kt140/ECE445_SeniorDesign/README.md

# ECE 445: Senior Design - Team 7

## 	Project - Optimized solar charging off grid for several output voltage potentials

This is the senior design project for Kanin Tangchartsiri (kanint2), Lukas Gollings (lwg2), and Wonjoon Lee (wonjoon2).
