kt140/ECE445_SeniorDesign/Notebooks/Kanin/BUCK_COLLAB_NOTEBOOK.jpg

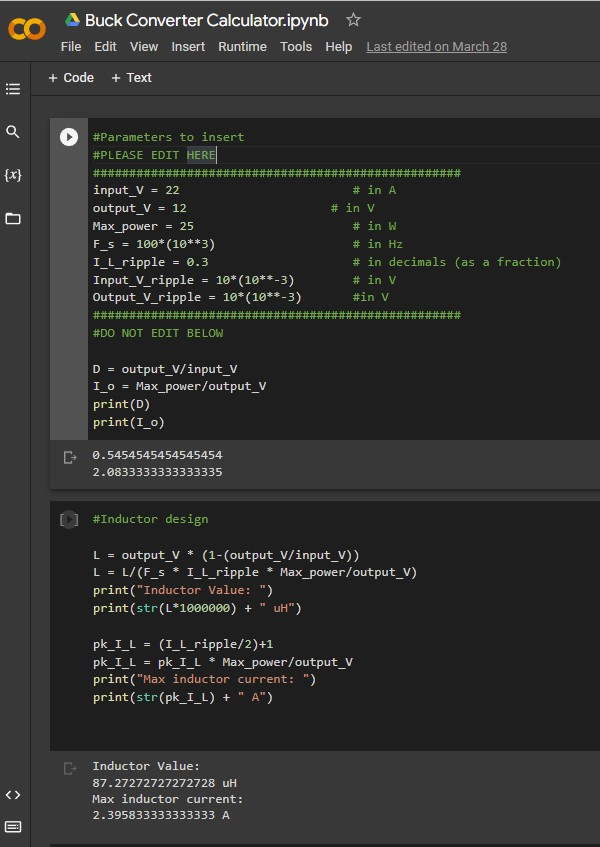
Notebooks/Kanin/BUCK_COLLAB_NOTEBOOK.jpg
