kt140/ECE445_SeniorDesign/Notebooks/Kanin/FINAL_GATE_DRIVERS.jpg

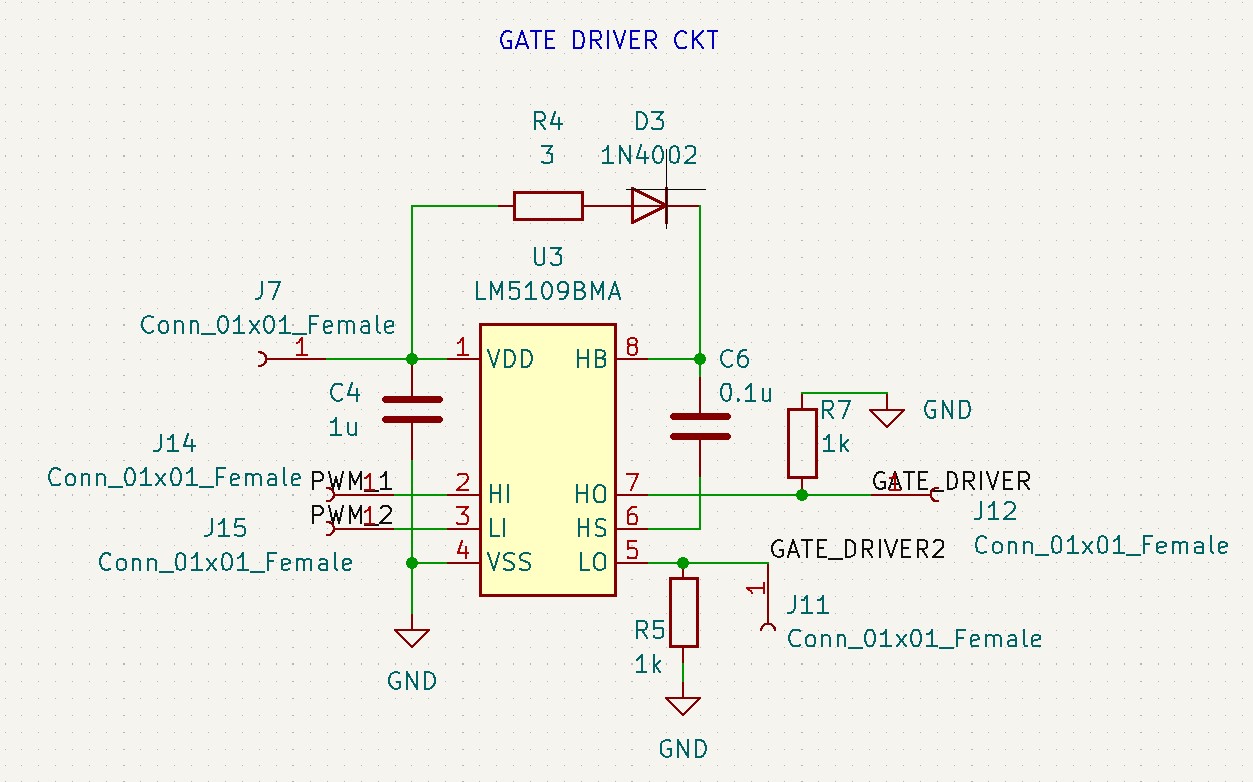
Notebooks/Kanin/FINAL_GATE_DRIVERS.jpg
