kt140/ECE445_SeniorDesign/Notebooks/Kanin/finalized_power_board_schem.jpg

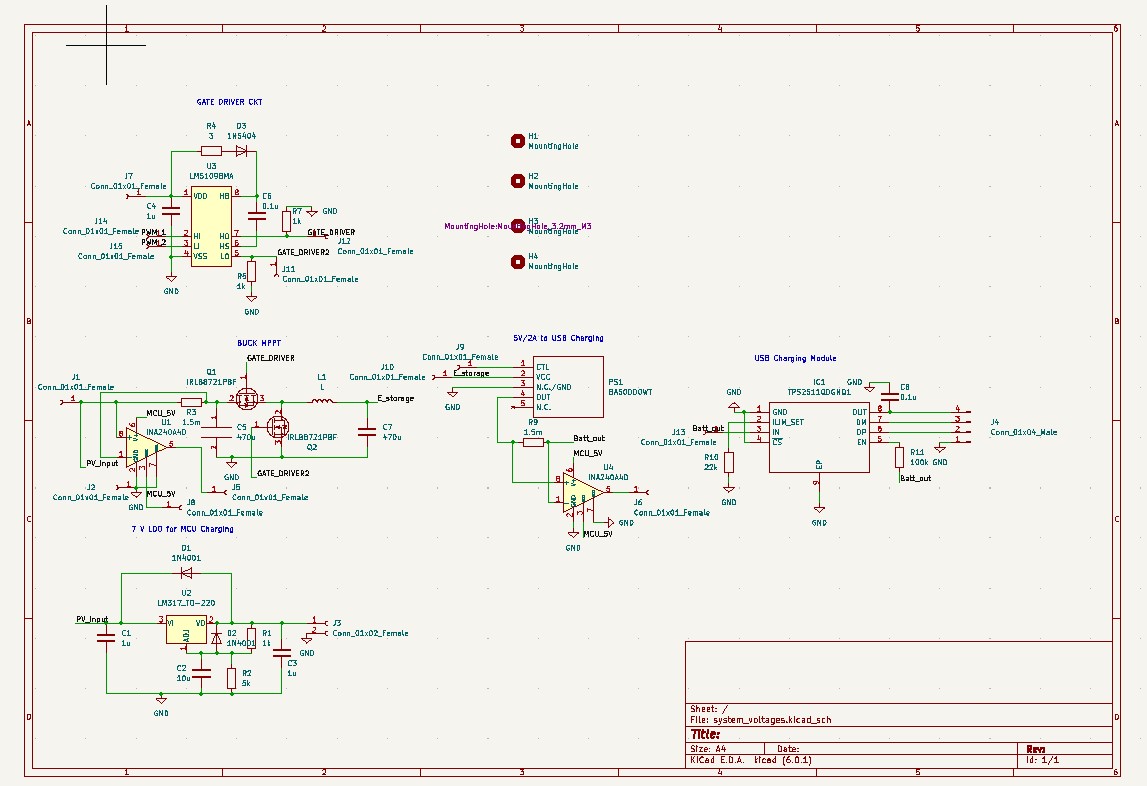
Notebooks/Kanin/finalized_power_board_schem.jpg
