kt140/ECE445_SeniorDesign/Notebooks/Kanin/incomplete_PCB.jpg

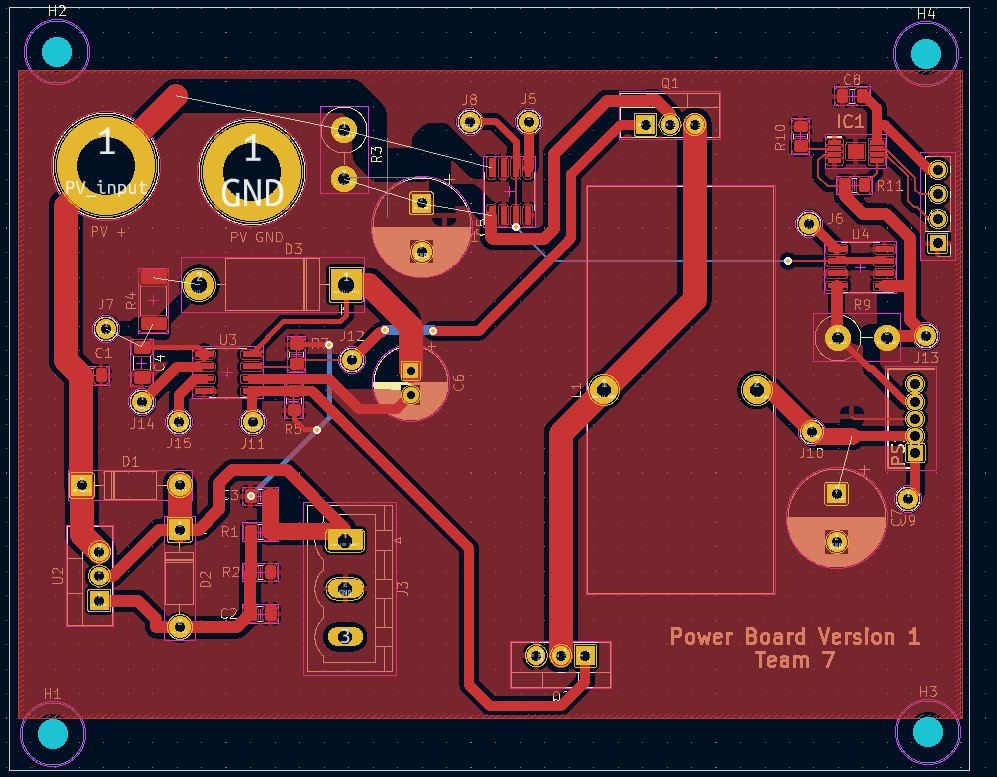
Notebooks/Kanin/incomplete_PCB.jpg
