kt140/ECE445_SeniorDesign/Notebooks/Kanin/runningsimulation4buckcorrection.jpg

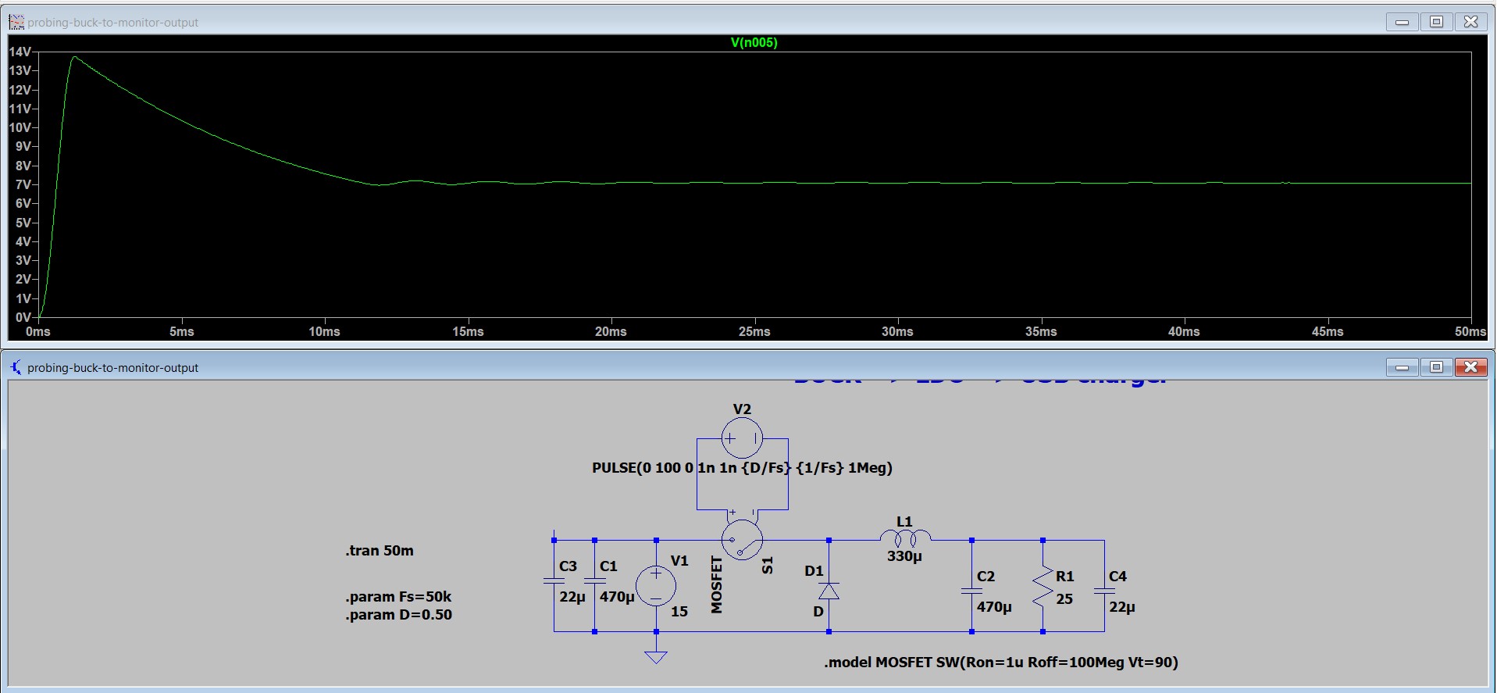
Notebooks/Kanin/runningsimulation4buckcorrection.jpg
