kt140/ECE445_SeniorDesign/Notebooks/Lukas/images_IPR/INA-block-diagram.PNG

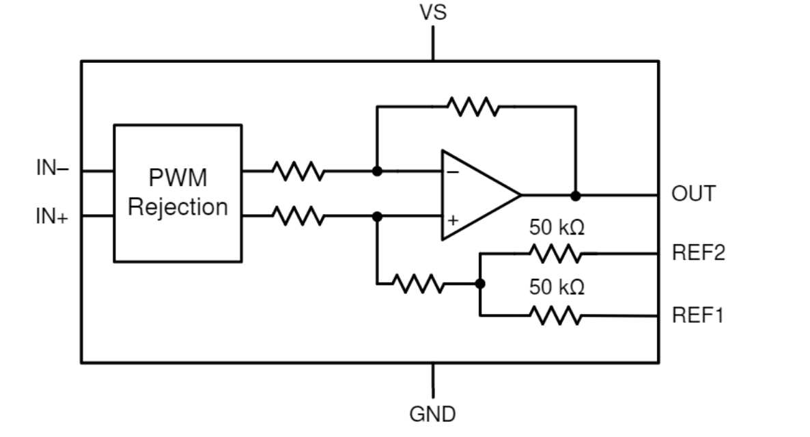
Notebooks/Lukas/images_IPR/INA-block-diagram.PNG
