kt140/ECE445_SeniorDesign/Notebooks/Lukas/images_IPR/inc-con-flowchart.PNG

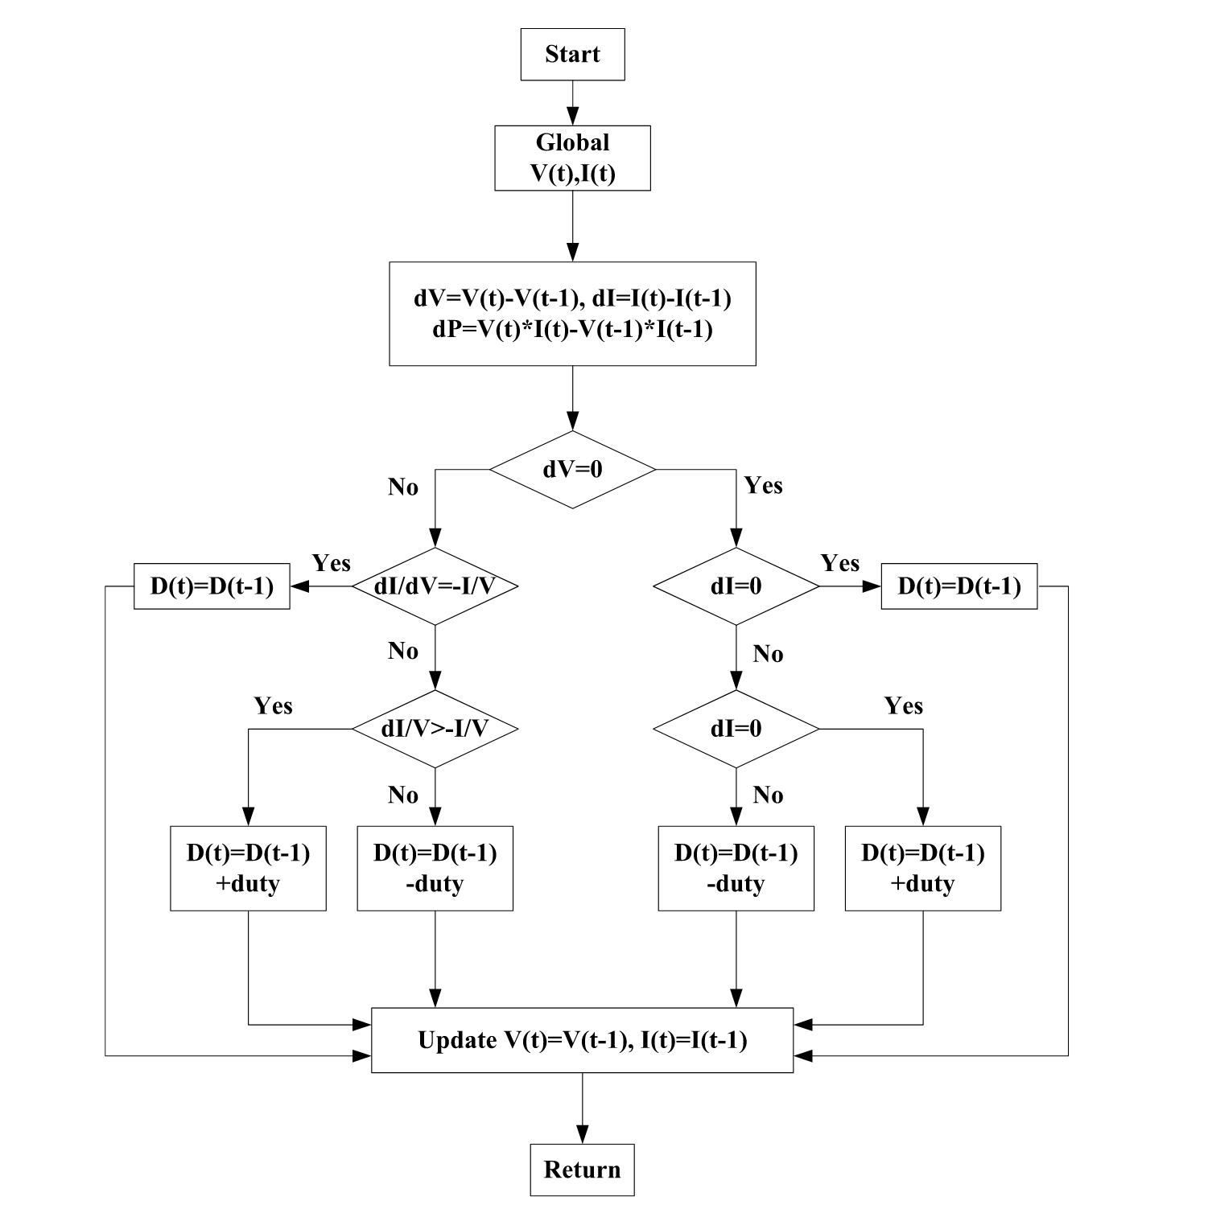
Notebooks/Lukas/images_IPR/inc-con-flowchart.PNG
