kt140/ECE445_SeniorDesign/Notebooks/Lukas/images_IPR/TPS2511-block-diagram.PNG

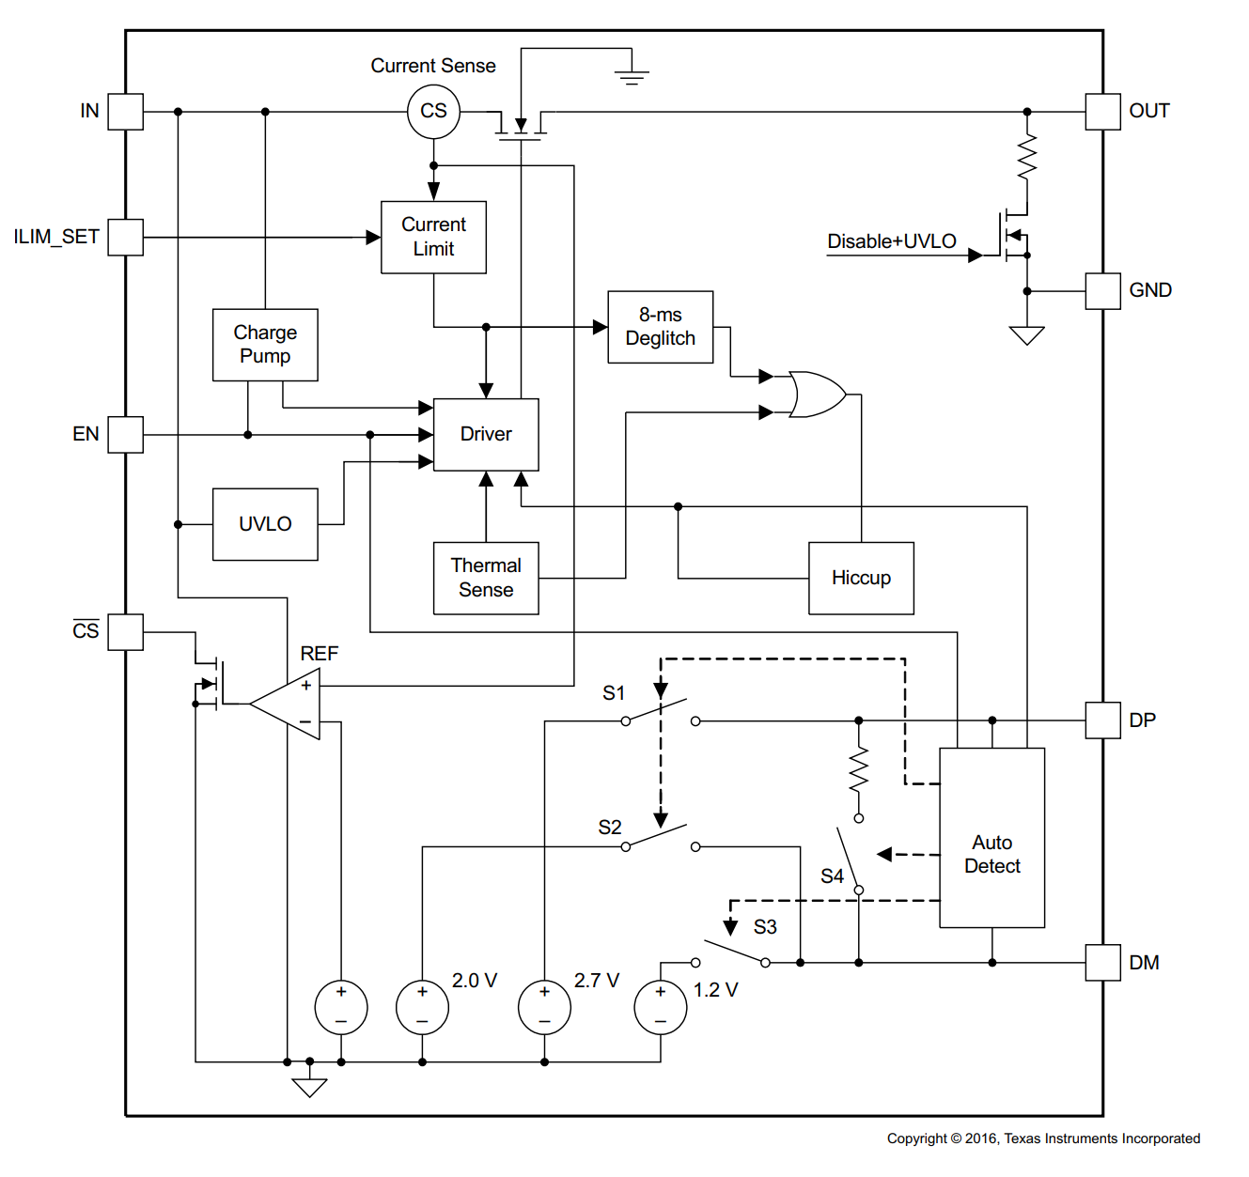
Notebooks/Lukas/images_IPR/TPS2511-block-diagram.PNG
