kt140/ECE445_SeniorDesign/Notebooks/Lukas/images_IPR/TPS2511-USB-auto-detect.PNG

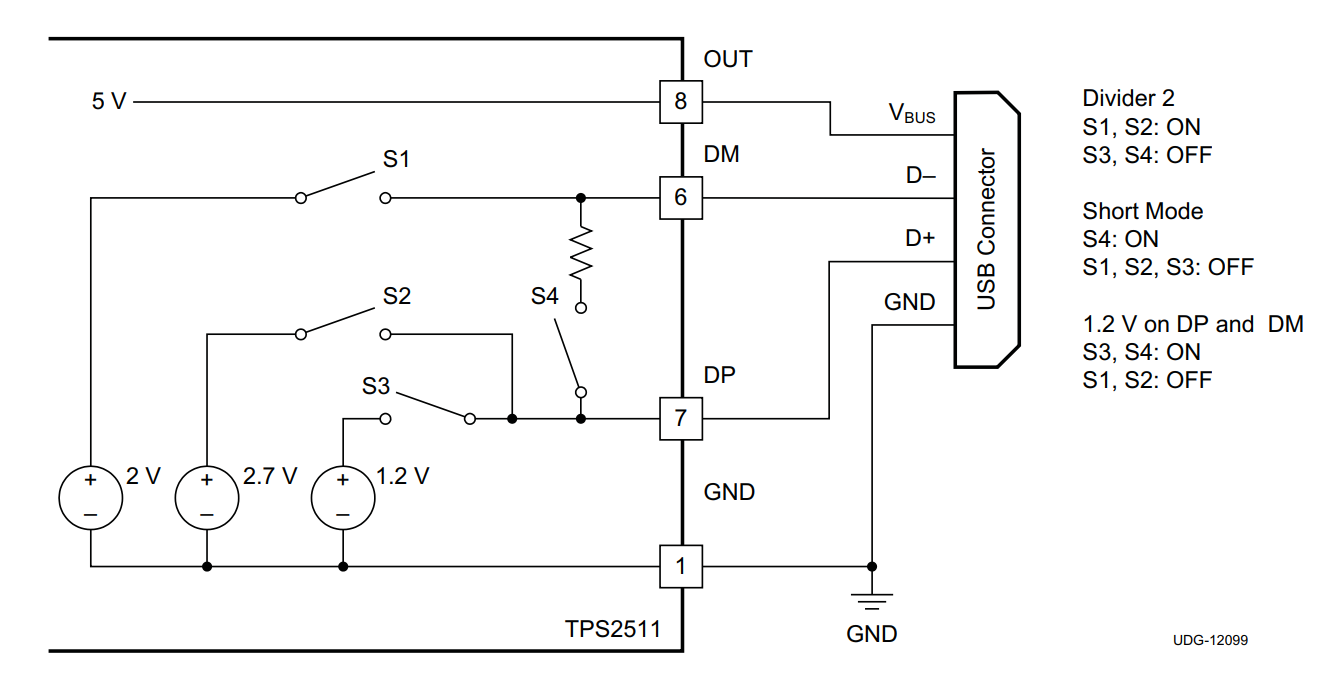
Notebooks/Lukas/images_IPR/TPS2511-USB-auto-detect.PNG
