kt140/ECE445_SeniorDesign/Notebooks/Lukas/images_markdown/279031682_566289591420830_5160905550239038735_n.jpg

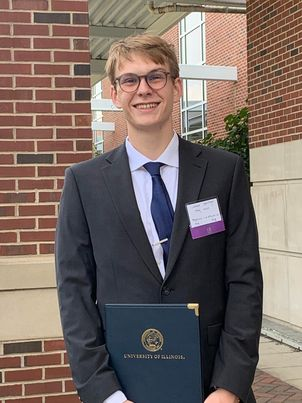
Notebooks/Lukas/images_markdown/279031682_566289591420830_5160905550239038735_n.jpg
