kt140/ECE445_SeniorDesign/Notebooks/Lukas/images_markdown/random-waveform.jpg

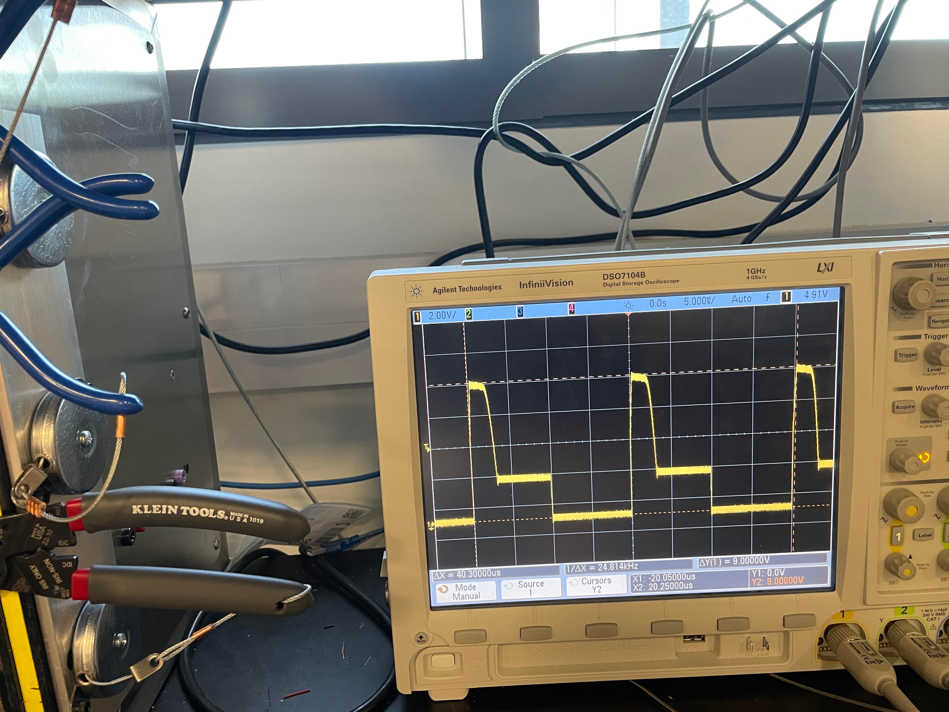
Notebooks/Lukas/images_markdown/random-waveform.jpg
