kt140/ECE445_SeniorDesign/Notebooks/Lukas/images_markdown/sched.PNG

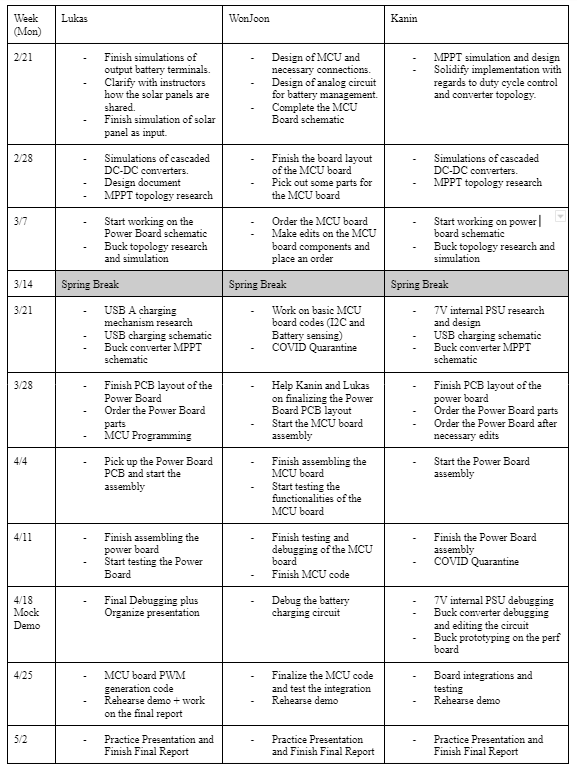
Notebooks/Lukas/images_markdown/sched.PNG
