kt140/ECE445_SeniorDesign/Simulation/NiCd Charging Sim/LM317LOGICTEST.png

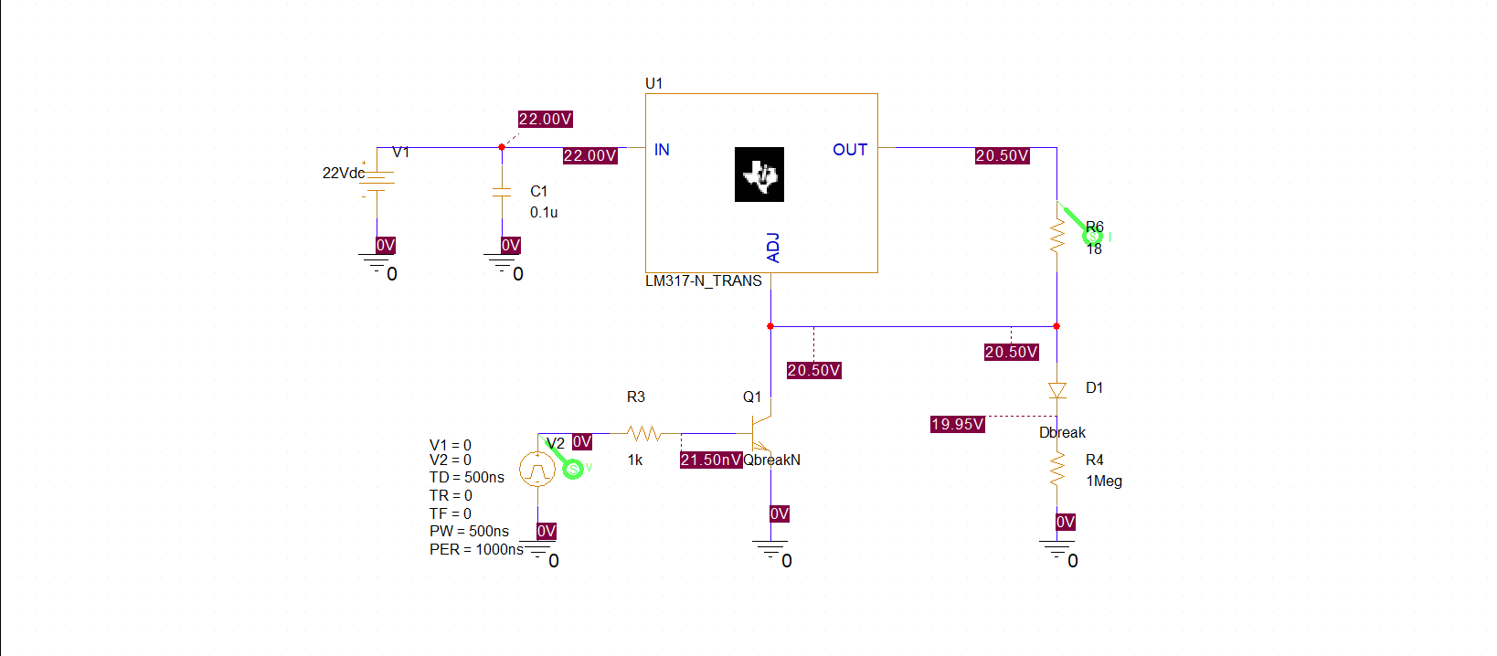
Simulation/NiCd Charging Sim/LM317LOGICTEST.png
