kt140/ECE445_SeniorDesign/Notebooks/Kanin/example_testpoint_pcb.jpg

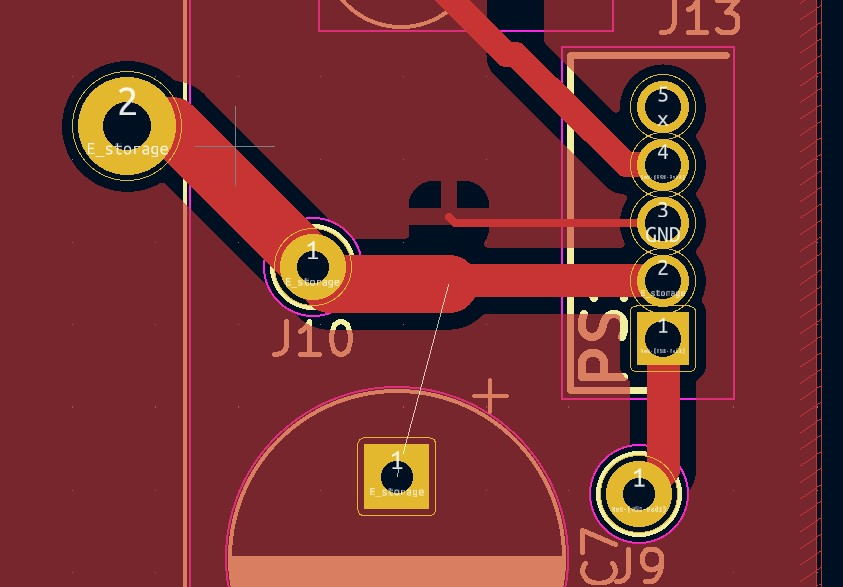
Notebooks/Kanin/example_testpoint_pcb.jpg
