kt140/ECE445_SeniorDesign/Notebooks/Kanin/example_testpoint_schematic.jpg

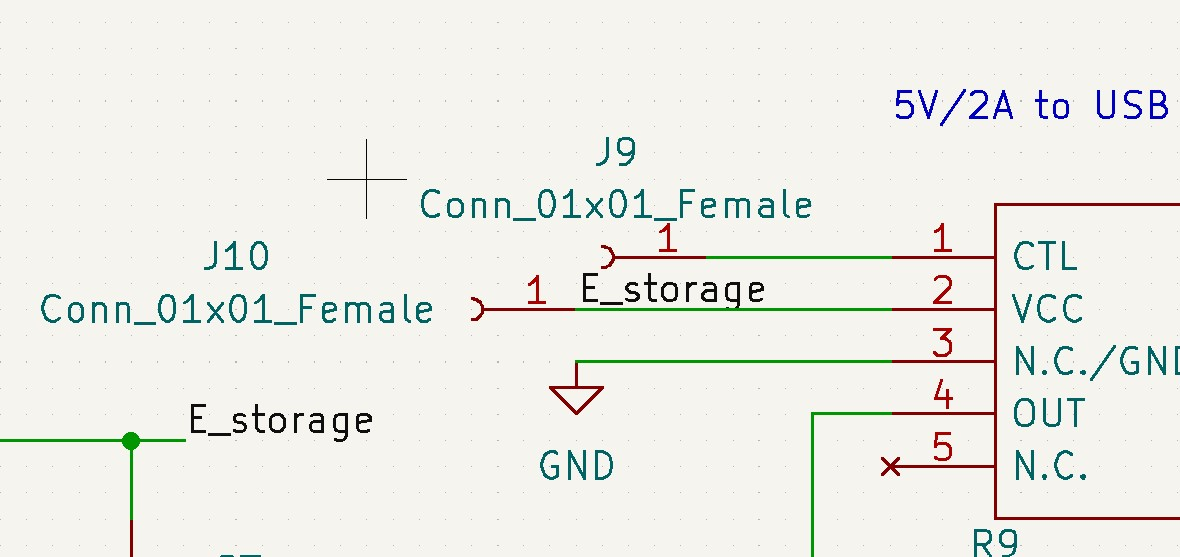
Notebooks/Kanin/example_testpoint_schematic.jpg
