kt140/ECE445_SeniorDesign/Notebooks/Lukas/images_markdown/5V_USB-verification.jpg

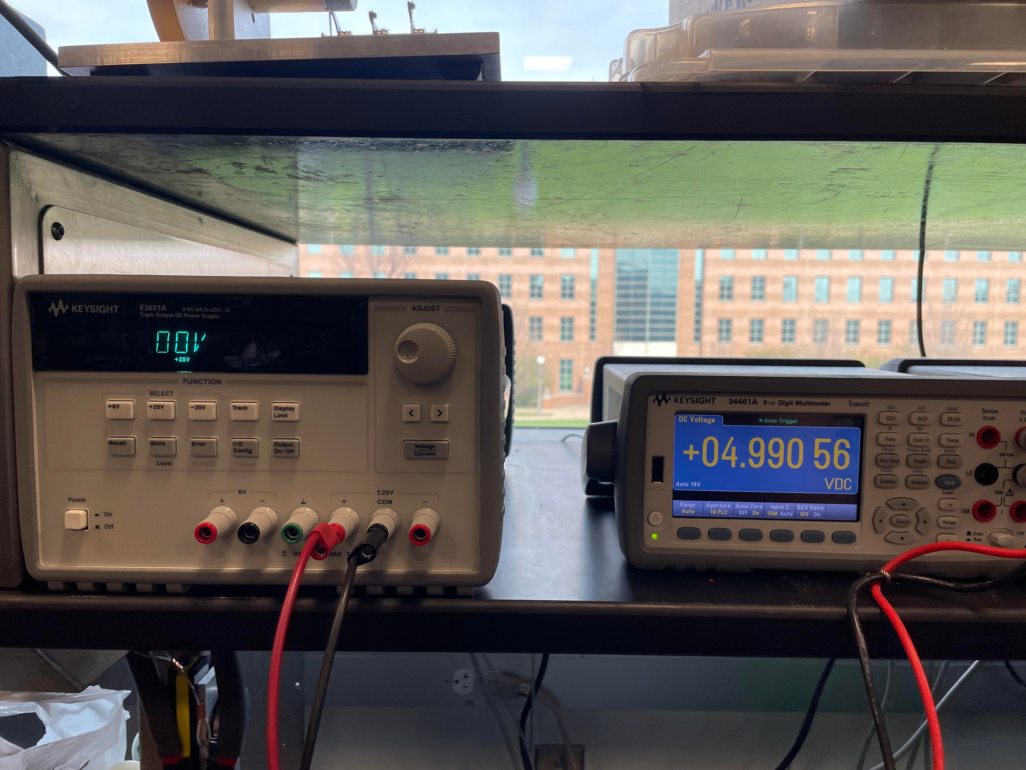
Notebooks/Lukas/images_markdown/5V_USB-verification.jpg
