kt140/ECE445_SeniorDesign/Simulation/NiCd Charging Sim/LM317LogicTest-PSpiceFiles/SCHEMATIC1/test1/test1.cir

** Profile: "SCHEMATIC1-test1"  [ D:\School_Works\Senior\Sem2\ECE445\NiCd Charging Sim\LM317LogicTest-PSpiceFiles\SCHEMATIC1\test1.sim ] 

** Creating circuit file "test1.cir" 
** WARNING: THIS AUTOMATICALLY GENERATED FILE MAY BE OVERWRITTEN BY SUBSEQUENT SIMULATIONS

*Libraries: 
* Profile Libraries :
* Local Libraries :
* From [PSPICE NETLIST] section of C:\cds_spb_home\cdssetup\OrCAD_PSpiceTIPSpice_Install\17.4.0\PSpice.ini file:
.lib "nom_pspti.lib" 
.lib "nom.lib" 

*Analysis directives: 
.TRAN  0 1000ns 0 
.OPTIONS ADVCONV
.OPTIONS FILEMODELSEARCH
.PROBE64 V(alias(*)) I(alias(*)) W(alias(*)) D(alias(*)) NOISE(alias(*)) 
.INC "..\SCHEMATIC1.net" 


.END
