kt140/ECE445_SeniorDesign/Notebooks/Lukas/Simulations/Forward_Converter.asc

C1: cap; 10µ
C2: cap; 10µ
D1: diode
D2: diode
L1: ind2; 1m
L2: ind2; 1m
L3: ind2; 1m
R1: res; 4
R2: res; 5k
R3: res; 10k
S1: sw
V1: voltage; 8
V2: voltage; PULSE(-1 1 0 1n 1n 1.666667u 3.333333u 1000)
Named nets: 0
K1 L1 L2 L3 0.5
.model SW SW(Ron = 1u)
.tran 0 50m 0 0.1m
