kt140/ECE445_SeniorDesign/(list of files, drawings)

Other design files:
Simulation/NiCd Charging Sim/LM317LOGICTEST.DSN
Simulation/NiCd Charging Sim/LM317LogicTest.opj
