kt140/ECE445_SeniorDesign/Schematics_kanin/system_voltages/system_voltages/system_voltages.kicad_pcb

## KiCad design Schematics_kanin/system_voltages/system_voltages/system_voltages.kicad_pcb (2022-04-06)

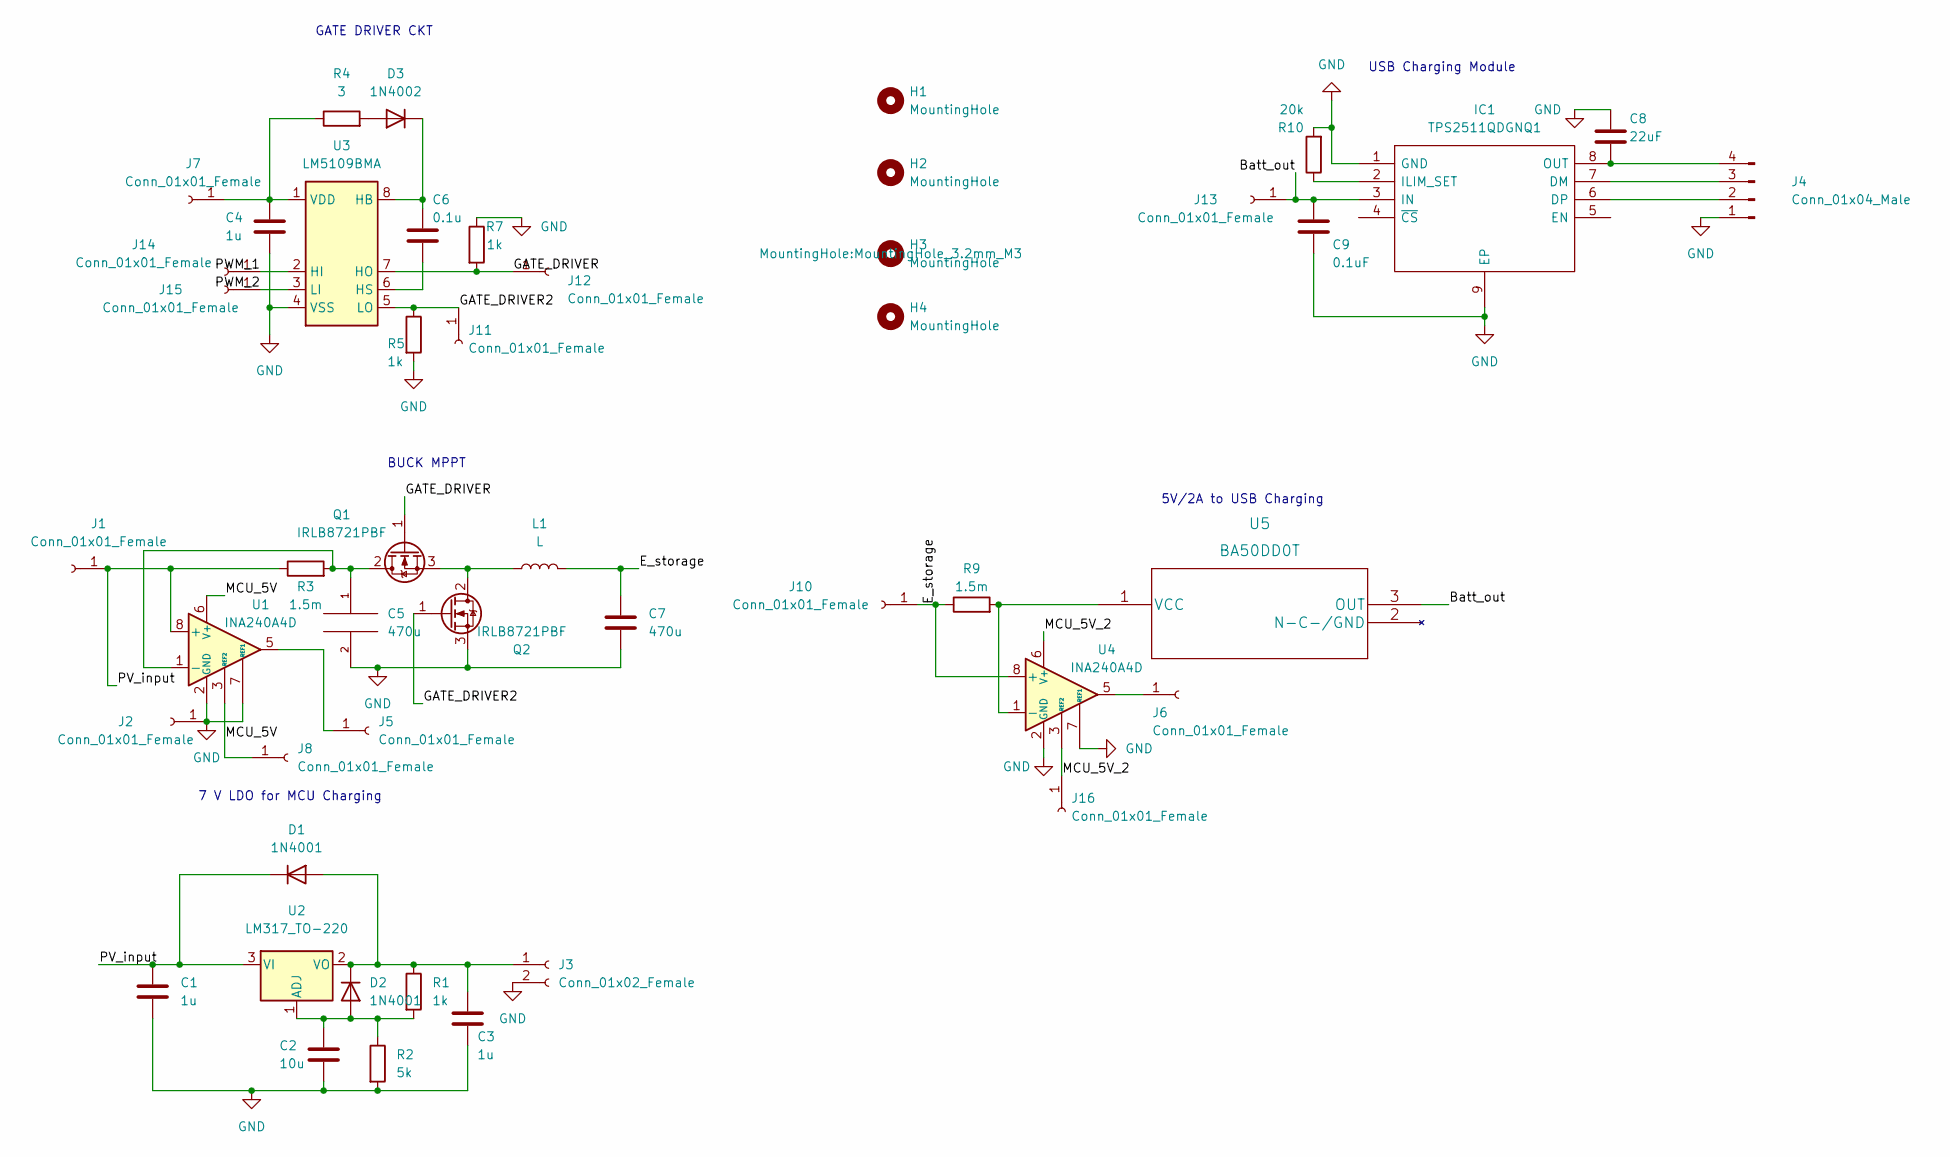
[picture p76: schematic system_voltages.kicad_sch]

Parts:
C1, C3, C4: 1u; C_0805_2012Metric_Pad1.18x1.45mm_HandSolder
C2: 10u; C_1210_3225Metric_Pad1.33x2.70mm_HandSolder
C5, C7: 470u; CP_Radial_D10.0mm_P5.00mm
C6: 0.1u; C_1206_3216Metric_Pad1.33x1.80mm_HandSolder
C8: 22uF; CP_Radial_D8.0mm_P5.00mm
C9: 0.1uF; C_1206_3216Metric_Pad1.33x1.80mm_HandSolder
D1, D2: 1N4001; D_DO-41_SOD81_P10.16mm_Horizontal
D3: 1N4002; D_DO-41_SOD81_P10.16mm_Horizontal
H1, H2, H3, H4: MountingHole; MountingHole_3.2mm_M3
IC1: TPS2511QDGNQ1; SOP65P490X110-9N; Mouser Part Number 595-TPS2511QDGNQ1
J1, J2: Conn_01x01_Female; Banana_Jack_1Pin
J3: Conn_01x02_Female; PhoenixContact_MSTBVA_2,5_3-G_1x03_P5.00mm_Vertical
J4: Conn_01x04_Male; PinHeader_1x04_P2.54mm_Vertical
J5, J6, J7, J8, J10, J11, J12, J13, J14, J15, J16: Conn_01x01_Female; Pin_D1.0mm_L10.0mm
L1: L; L_Toroid_Vertical_L35.1mm_W21.1mm_P18.50mm_Vishay_TJ6
Q1, Q2: IRLB8721PBF; TO-220-3_Vertical
R1: 1k; R_Axial_DIN0516_L15.5mm_D5.0mm_P25.40mm_Horizontal
R2: 5k; R_Axial_DIN0617_L17.0mm_D6.0mm_P20.32mm_Horizontal
R3, R9: 1.5m; R_2512_6332Metric_Pad1.40x3.35mm_HandSolder
R4: 3; R_2010_5025Metric_Pad1.40x2.65mm_HandSolder
R5, R7: 1k; R_0805_2012Metric_Pad1.20x1.40mm_HandSolder
R10: 20k; R_Axial_DIN0207_L6.3mm_D2.5mm_P10.16mm_Horizontal
U1, U4: INA240A4D; SOIC-8_3.9x4.9mm_P1.27mm
U2: LM317_TO-220; TO-220-3_Vertical
U3: LM5109BMA; SOIC-8_3.9x4.9mm_P1.27mm
U5: BA50DD0T

Connections:
/Batt_out: C9.1, IC1.3 (IN), J13.1, U5.3 (OUT)
/E_storage: C7.1, J10.1, L1.2, R9.1, U4.8 (+)
/GATE_DRIVER: J12.1, Q1.1 (G), R7.2, U3.7 (HO)
/GATE_DRIVER2: J11.1, Q2.1 (G), R5.1, U3.5 (LO)
/MCU_5V: J8.1, U1.3 (REF2), U1.6 (V+)
/MCU_5V_2: J16.1, U4.3 (REF2), U4.6 (V+)
/PV_input: C1.1, D1.1 (K), J1.1, R3.1, U1.8 (+), U2.3 (VI)
/PWM_1: J14.1, U3.2 (HI)
/PWM_2: J15.1, U3.3 (LI)
GND: C1.2, C2.2, C3.2, C4.2, C5.2, C7.2, C8.1, C9.2, IC1.1 (GND), IC1.9 (EP), J2.1, J3.2, J4.1, Q2.3 (S), R2.2, R5.2, R7.1, R10.2, U1.2 (GND), U1.4 (GND), U1.7 (REF1), U3.4 (VSS), U4.2 (GND), U4.4 (GND), U4.7 (REF1)
unnamed: C2.1, D2.2 (A), R1.2, R2.1, U2.1 (ADJ)
unnamed: C3.1, D1.2 (A), D2.1 (K), J3.1, R1.1, U2.2 (VO)
unnamed: C4.1, J7.1, R4.1, U3.1 (VDD)
unnamed: C5.1, Q1.2 (D), R3.2, U1.1 (-)
unnamed: C6.1, D3.1 (K), U3.8 (HB)
unnamed: C6.2, U3.6 (HS)
unnamed: C8.2, IC1.8 (OUT), J4.4
unnamed: IC1.2 (ILIM_SET), R10.1
unnamed: IC1.6 (DP), J4.2
unnamed: IC1.7 (DM), J4.3
unnamed: J5.1, U1.5
unnamed: J6.1, U4.5
unnamed: L1.1, Q1.3 (S), Q2.2 (D)
unnamed: D3.2 (A), R4.2
unnamed: R9.2, U4.1 (-), U5.1 (VCC)

Notes on the sheet:
BUCK MPPT
5V/2A to USB Charging
GATE DRIVER CKT
7 V LDO for MCU Charging
USB Charging Module

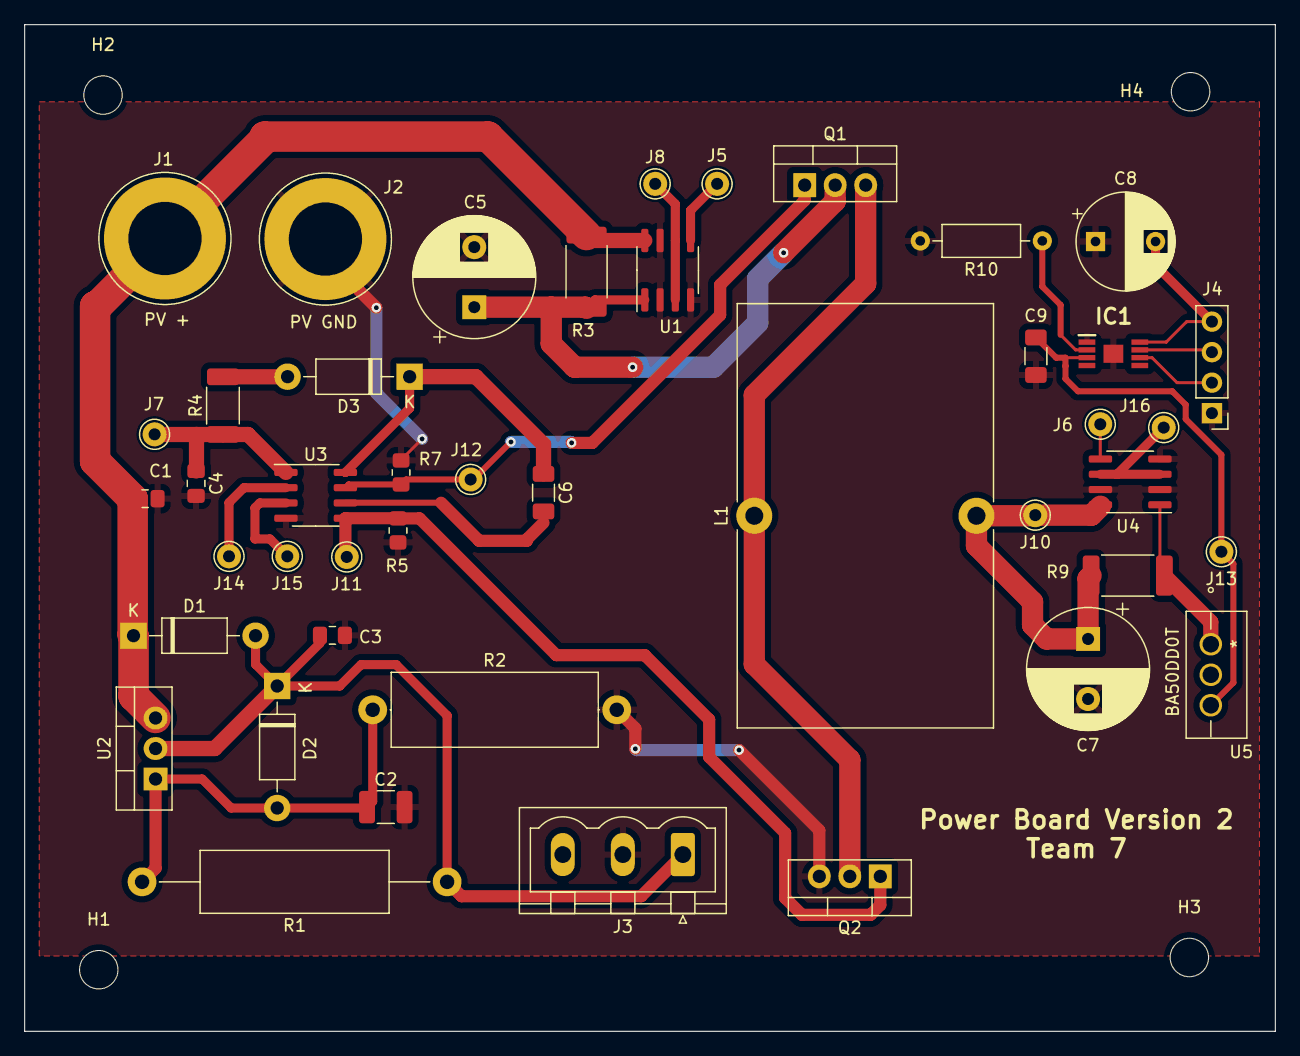
[picture p77: board system_voltages.kicad_pcb from above]

Board: 2 copper layers, 104.1 x 83.8 mm, 48 parts (0 on the bottom side), 25 nets.
