kt140/ECE445_SeniorDesign/Code/Display Code/I2C_Display/I2C_Display.ino

#include <Wire.h>

void setup()
{
  Serial.begin (115200);
   while (!Serial)
    {
    }

  Serial.println ();
  Serial.println ("I2C scanner. Scanning ...");
  byte count = 0;
  pinMode(13,OUTPUT); 
  digitalWrite(13,HIGH);
  Wire.begin();
  for (byte i = 1; i < 120; i++)
  {
    Wire.beginTransmission (i);
    if (Wire.endTransmission () == 0)
      {
      Serial.print ("Found address: ");
      Serial.print (i, DEC);
      Serial.print (" (0x");
      Serial.print (i, HEX);
      Serial.println (")");
      count++;
      delay (1); 
      } 
  } 
  Serial.println ("Done.");
  Serial.print ("Found ");
  Serial.print (count, DEC);
  Serial.println (" device(s).");
} 

void loop() {
  // put your main code here, to run repeatedly:

}
