kt140/ECE445_SeniorDesign/Code/Display Code/I2C_Display/I2C_Display_Custom/I2C_Display_Custom.ino

#include <SPI.h>
#include <Wire.h>
#include <Adafruit_GFX.h>
#include <Adafruit_SSD1306.h>

#define OLED_RESET 4
Adafruit_SSD1306 display(OLED_RESET);

void setup() {
  display.begin(SSD1306_SWITCHCAPVCC, 0x3C);
  display.clearDisplay();
}

void loop() {
  // put your main code here, to run repeatedly:
  display.setTextSize(1);
  display.setTextColor(WHITE);
  display.setCursor(0,0);
  display.println("Battery level is: ");
  display.display();
}
