kt140/ECE445_SeniorDesign/(commit log)

2022-03-02 Adding a basic schematics folder
    [buck_converter.kicad_pcb, buck_converter.kicad_sch]
2022-03-10 Added some kicad
2022-03-12 Added 7 V circuit schematic
    [buck_converter.kicad_sch]
2022-03-12 Nearly done with 7V MCU ckt, need to size output cap
    [buck_converter.kicad_sch]
2022-03-13 Added new entry to worklog for Yei, Initial PCB Design
2022-03-17 Added a few values to schematic
    [buck_converter.kicad_sch]
2022-03-18 Adding new datasheet with LM5009 use cases
    [buck_converter.kicad_sch]
2022-03-20 Added new design for 7 V output
    [buck_converter.kicad_sch, system_voltages.kicad_pcb, system_voltages.kicad_sch]
2022-03-20 Logged spring break work
2022-03-20 USB 5V/2A Research
2022-03-21 WonJoon Notebook Updated, Simulation, Code updated
    [LM317LOGICTEST.DSN, LM317LogicTest.opj]
2022-03-21 Made some changes for system voltages
    [system_voltages.kicad_sch]
2022-03-22 Added entry to Kanin's log + finished schematic of MCU 7V
    [system_voltages.kicad_sch]
2022-03-24 Updated 7 V MCU
    [system_voltages.kicad_sch]
2022-03-25 Added buck and USB charging
    [system_voltages.kicad_sch]
2022-03-26 Added 5V/2A LDO
    [system_voltages.kicad_sch]
2022-03-26 Pushing everything for Lukas
    [system_voltages.kicad_sch]
2022-03-27 Heat sink, some current sense, more references
2022-03-27 Adding changes to kicad
2022-03-27 Added entry + gate drivers
2022-03-27 Adding changes to gate driver ckt
    [system_voltages.kicad_sch]
2022-03-28 Started routing our footprints
    [system_voltages.kicad_sch]
2022-04-06 Pushing again for updates
    [buck_converter.kicad_pcb, buck_converter.kicad_sch, system_voltages.kicad_pcb, system_voltages.kicad_sch]
2022-04-06 Adding schematics for power board
    [buck_converter.kicad_pcb, buck_converter.kicad_sch, generating_BOM.xlsx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]
2022-04-06 Added PCB work
2022-04-06 committed BOM and PCB changes
2022-04-25 Adding buck converter simulation images
2022-05-04 Adding gate drivers
